gyrofx/qmk_firmware/keyboards/0_gyrofx/readme.md

# gyrofx

Self-made keyboards by [gyrofx](https://github.com/gyrofx).

* [mml](mml/readme.md): handwired 68-key 65 % keyboard, 3D-printed case, Raspberry Pi Pico (`0_gyrofx/mml`)
