gyrofx/qmk_firmware/keyboards/0_gyrofx/mml/case/keyboard-case.FCStd

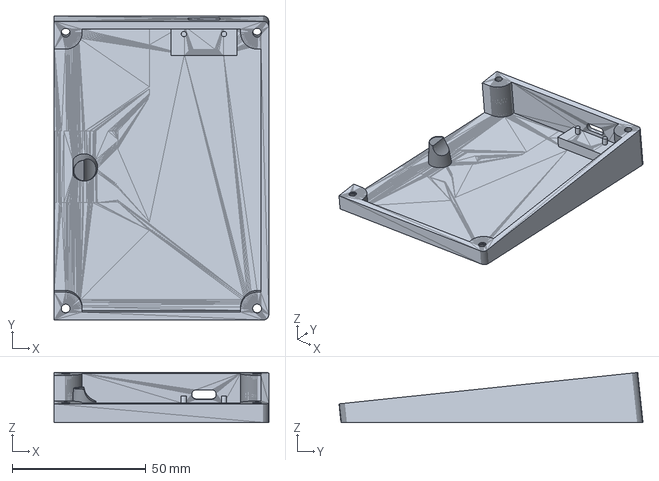
[picture p3: CAD file, 2026-10-18]
keyboards/0_gyrofx/mml/case/keyboard-case.FCStd
80.2 x 113.6 x 18.7 mm
