gyrofx/qmk_firmware/keyboards/0_gyrofx/mml/case/original/BezelRight.stl

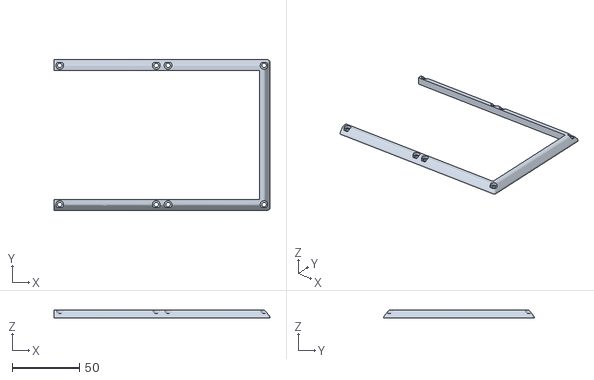
[picture p4: CAD file, 2026-10-18]
keyboards/0_gyrofx/mml/case/original/BezelRight.stl
160.9 x 112.3 x 6.00
