gyrofx/qmk_firmware/keyboards/0_gyrofx/mml/case/original/ISOPlateTopLeft.stl

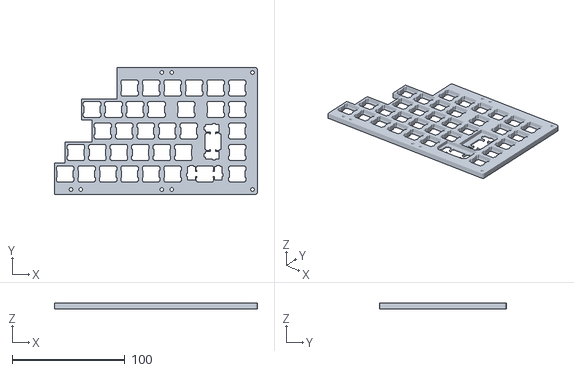
[picture p5: CAD file, 2026-10-18]
keyboards/0_gyrofx/mml/case/original/ISOPlateTopLeft.stl
179.8 x 112.3 x 5.00
