gyrofx/qmk_firmware/keyboards/0_gyrofx/mml/case/original/ISOPlateTopRight.stl

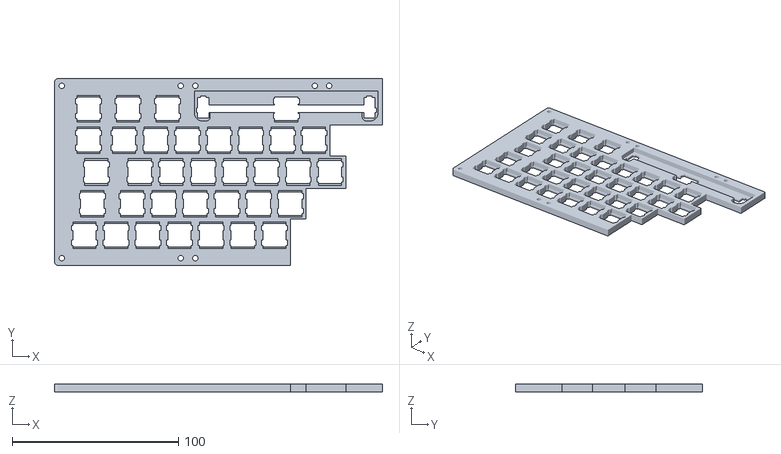
[picture p6: CAD file, 2026-10-18]
keyboards/0_gyrofx/mml/case/original/ISOPlateTopRight.stl
197.3 x 112.3 x 5.00
