gyrofx/qmk_firmware/keyboards/0_gyrofx/mml/case/original/BottomMiddle.stl

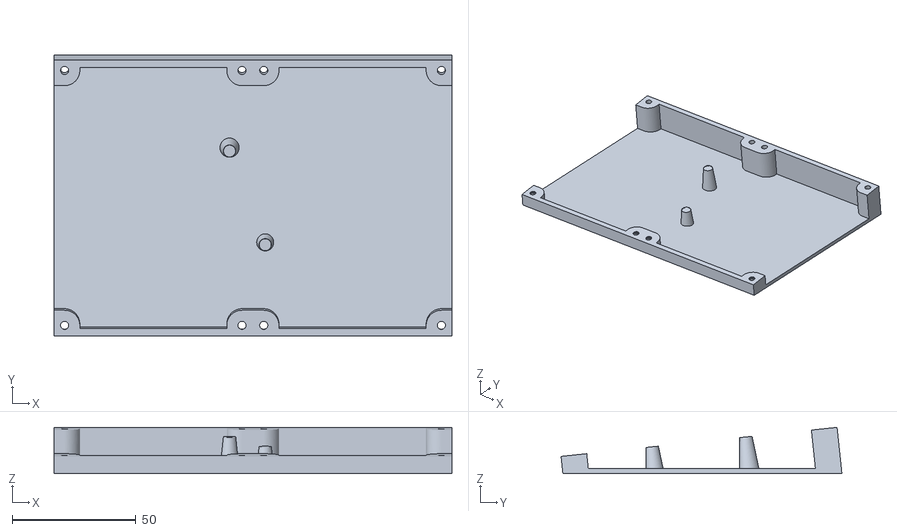
[picture p7: CAD file, 2026-10-18]
keyboards/0_gyrofx/mml/case/original/BottomMiddle.stl
161.0 x 113.6 x 18.7
