gyrofx/qmk_firmware/(list of files, cad)

Other CAD files:
keyboards/0_gyrofx/mml/case/BottomRight-modified.3mf
keyboards/0_gyrofx/mml/case/original/BottomLeft.stl
keyboards/0_gyrofx/mml/case/original/ANSI Plate Right.stl
keyboards/0_gyrofx/mml/case/original/ANSI Plate Left.stl
keyboards/0_gyrofx/mml/case/original/BottomRight.stl
keyboards/0_gyrofx/mml/case/original/BezelLeft.stl
