gyrofx/qmk_firmware/keyboards/0_gyrofx/mml/case/original/printables-307908.pdf

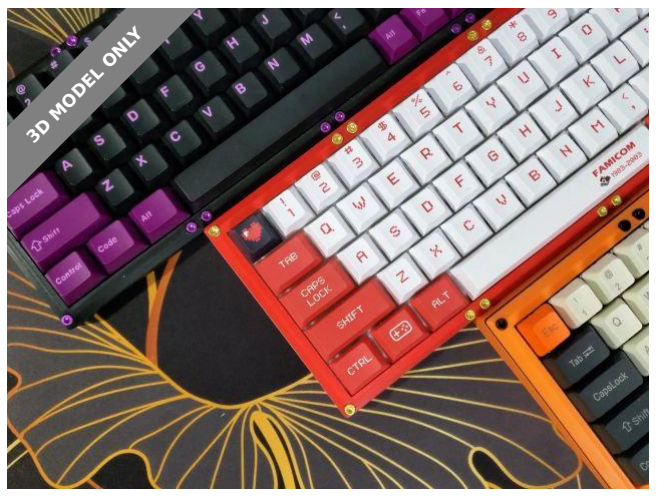
[picture p8: figure]
3D MODEL ONLY

# Summary

Please check out the assembly tutorial for this project: https://youtu.be/

### iOeYkLlq9Ds

Gadgets (https://printables.com/model?categoryId=21) | > | Computers (https://printables.com/model?categoryId=27)
Tags: gaming | computer | gadget | arduino | controller
keyboard | mechanicalkeyboard | streaming | technology

teensy

Please check out the assembly tutorial for this project:

Update 10/31/2022: Added ISO layout plate version.

This keyboard is a revision of a 3D printed Keyboard originally designed

my Thingiverse user Fumbucker: https://www.thingiverse.com/thing:
3010436

This build uses a Teensy 2.0 and QMK firmware. If you would like to flash

the included firmware, make sure your wiring matches the included wiring

diagram.

You will need:

### 1 - Teensy 2.0

Mad Mod Labs (https://printables.com/@MadModLabs)

# MECHANICAL KEYBOARD - 68 KEY

- 65%

### VIEW IN BROWSER (https://printables.com/model/307908-mechanical-keyboard-68-key-65)

updated 25. 9. 2023 | published 25. 9. 2023

# Model files

### 68 - 1N4148 Diodes

68 - of your favorite mechanical keyboard switches

A compatible keycap set

3 - 2unit plate mount stabilizers

1 - 6.25 plate mount stabilizer for the spacebar

1 - USBC Breakout board

### 8 - 12mm M3 bolts 8 - 20mm M3 bolts 16 - M3 nuts

Some wire and maybe some rubber feet for the bottom

### 3D PRINTING SETTINGS

### Material: PLA Infill: 20%

Layer Height: .2mm

Supports: No

# This remix is based on

Clueboard / FC660m 66% Mechanical Keyboard v2 (https://printables.com/model/128577-clueboard-fc660m-66-mechanical-keyboard-v2)

by sperm (https://printables.com/@sperm)

ansi-plate-left.stl

ansi-plate-right.stl

bottomright.stl

# Other files

# License

This work is licensed under a

Creative Commons (4.0 International License) (http://creativecommons.org/licenses/by-nc-sa/4.0/)

bottommiddle.stl

bottomleft.stl

bezelright.stl

bezelleft.stl

isoplatetopleft.stl

isoplatetopright.stl

keyboard-files.zip

Attribution—Noncommercial—Share Alike (http://creativecommons.org/licenses/by-nc-sa/4.0/)

### ✖ | Sharing without ATTRIBUTION

✔ | Remix Culture allowed
✖ | Commercial Use
✖ | Free Cultural Works
✖ | Meets Open Definition
