gyrofx/qmk_firmware/(commit log)

2026-01-27 Add initial files for Gyrofx keyboard
2026-10-18 gyrofx mml: switch to Raspberry Pi Pico, add build docs and case files
    - Firmware now targets the RP2040 (Pico) build: cols GP0-GP6, GP9-GP17, rows GP18-GP22
    - Remove the STM32 Blue Pill config (never built)
    - Add full build guide: parts, printing, case change, matrix, Pico pins, USB-C wiring, flashing, troubleshooting
    - Add printable solder plan and build photos
    - Add original Printables #307908 case files and the modified bottom-right part (FreeCAD + 3MF)
    [ANSI Plate Left.stl, ANSI Plate Right.stl, BezelLeft.stl, BezelRight.stl, BottomLeft.stl, BottomMiddle.stl, BottomRight-modified.3mf, BottomRight.stl]
2026-10-18 gyrofx mml: add build photos and Printables PDF
    These are excluded by the repo .gitignore (*.jpg, *.pdf) but referenced by the readme.
2026-11-07 gyrofx mml: add backtick on Fn+Backspace
    Grave Escape only gives ~ with Shift, and GUI+Esc is a GNOME shortcut,
    so there was no way to type a plain backtick.
